TobiasWallner/HighFrequenzyCircuits/Ordering.txt

Resistors-Jumpers
=================

Coils:
======
 * L 
	Or the following one because it allows more current but has slightly less inductance:
	Murata LQW15AN_00 Drosselspule mit Ferrit-Kern, 56 nH / ±5%, 8GHz 200mA, 0402 (1005M) Gehäuse
	https://at.rs-online.com/web/p/smd-induktivitat/8119641

Capazitors:
===========

 * C1, C2 1.5pF (Frequenzy Specific)
	KYOCERA AVX, U, SMD MLCC, Vielschicht Keramikkondensator C0G, 1.5pF ±0.1pF / 200V dc, Gehäuse 0603 (1608M)
	https://at.rs-online.com/web/p/keramik-vielschichtkondensatoren/6983986
	
 * C3 15pF (Frequenzy Specific)
	KYOCERA AVX, U, SMD MLCC, Vielschicht Keramikkondensator C0G, 15pF ±2% / 200V dc, Gehäuse 0805 (2012M)
	https://at.rs-online.com/web/p/keramik-vielschichtkondensatoren/6984042
	
 * C6 0.3pF (Frequenzy Specific)
	ML03V10R3AAT2A
	Keramikvielschichtkondensator, SMD, Hi-Q®, 0.3 pF, 250 V, 0603 [Metrisch: 1608], ± 0.05pF, ML
	https://at.farnell.com/avx/ml03v10r3aat2a/kondensator-0-3pf-250v-0603/dp/2252672
	
 * C4 100p (Can be any other cheap one)
	KYOCERA AVX, U, SMD MLCC, Vielschicht Keramikkondensator C0G, 100pF ±5% / 200V dc, Gehäuse 0805 (2012M)
	https://at.rs-online.com/web/p/keramik-vielschichtkondensatoren/6984036

 * C5 1n (Can be any other cheap one)
	KEMET, C, SMD MLCC, Vielschicht Keramikkondensator X7R, 1nF ±10% / 50V dc, Gehäuse 0603 (1608M)
	https://at.rs-online.com/web/p/keramik-vielschichtkondensatoren/2644551
 
 * 2,2µF (Can be any other cheap one)
	Murata, GCM, SMD MLCC, Vielschicht Keramikkondensator X7R, 2.2μF ±10% / 10V dc, Gehäuse 0805 (2012M), AEC-Q200
	https://at.rs-online.com/web/p/keramik-vielschichtkondensatoren/8202914
	
 * 22nF (Can be any other cheap one)
	Murata, GCM, SMD MLCC, Vielschicht Keramikkondensator X7R, 22nF ±10% / 100V dc, Gehäuse 0603 (1608M), AEC-Q200
	https://at.rs-online.com/web/p/keramik-vielschichtkondensatoren/7235010
 
SMA Connector 50Ohm
https://at.rs-online.com/web/p/koaxial-steckverbinder/8858778
