TobiasWallner/HighFrequenzyCircuits/Documentation/Microstrip Line Calculation For RO400C3 PCB Material at 50Ohm for 2_45GHz.PNG

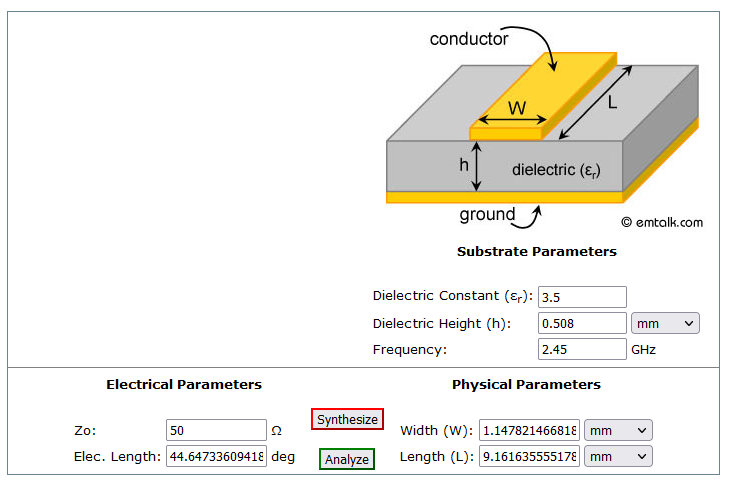
Documentation/Microstrip Line Calculation For RO400C3 PCB Material at 50Ohm for 2_45GHz.PNG
