TobiasWallner/HighFrequenzyCircuits/Documentation/Impedance and Reflectance against permitivity.pdf

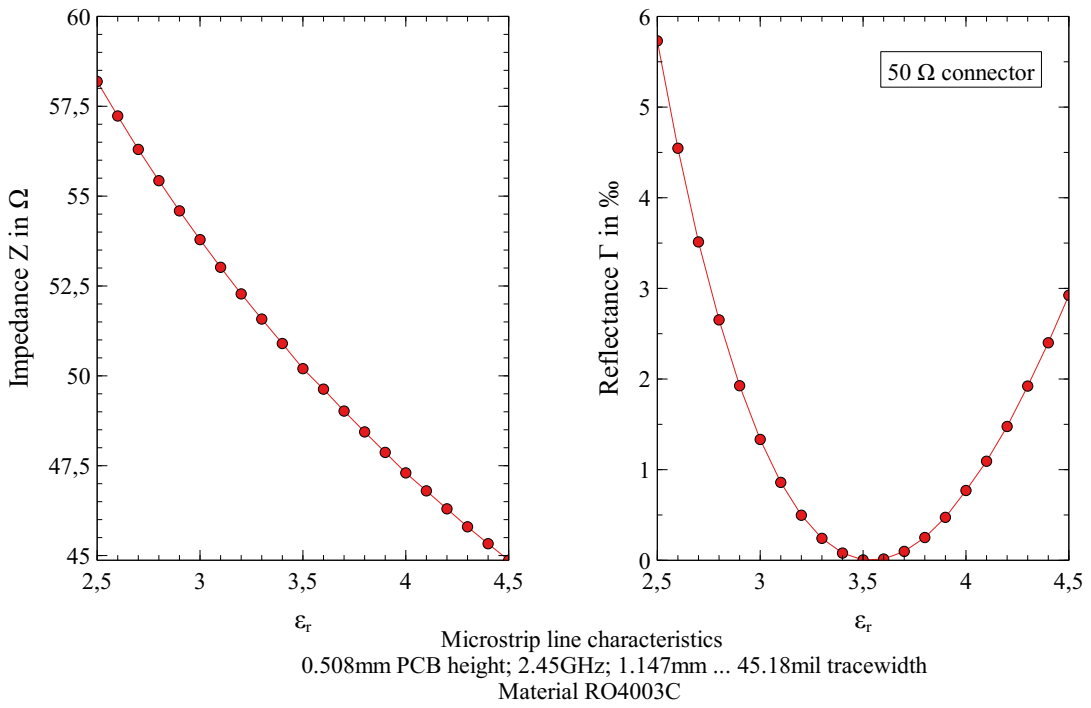
[picture p2: page 1]
Material RO4003C; 50 Ω connector; fle; cta

Microstrip line characteristics

0.508mm PCB height; 2.45GHz; 1.147mm ... 45.18mil tracewidth
