TobiasWallner/HighFrequenzyCircuits/Amplifier2450.brd

## EAGLE design Amplifier2450.brd (2022-04-04)

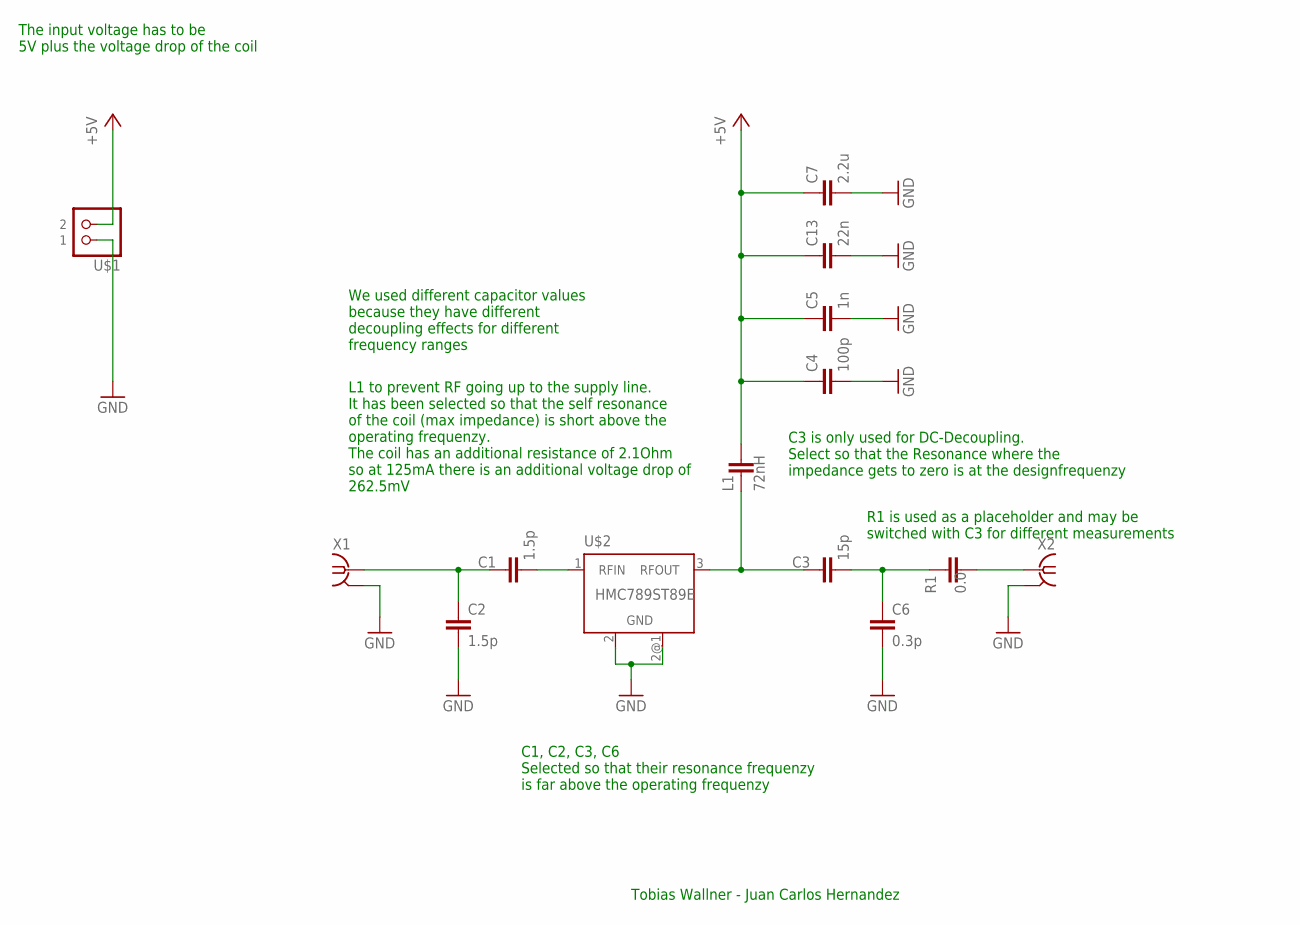
[picture p3: schematic Amplifier2450.sch]

Parts:
C1, C2: 1.5p; C0603
C3: 15p; C0603
C4: 100p; C0603
C5: 1n; C0603
C6: 0.3p; C0603
C7: 2.2u; C0805
C13: 22n; C0603
L1: 72nH; C0603
R1: 0.0; C0603
U$1: SKB_1X02_RM_5.12; RM_5.12_1X02
U$2: HMC789ST89E; SOT89
X1, X2: SMA-142-0701-801/806; J502-ND-142-0701-801/806

Connections:
+5V: C4.1, C5.1, C7.1, C13.1, L1.1, U$1.P$2 (2)
GND: C2.2, C4.2, C5.2, C6.2, C7.2, C13.2, U$1.P$1 (1), U$2.2 (GND), U$2.2@1 (GND), X1.G@1 (2), X1.G@2 (2), X1.G@3 (2), X1.G@4 (2), X2.G@1 (2), X2.G@2 (2), X2.G@3 (2), X2.G@4 (2)
unnamed: C3.1, L1.2, U$2.3 (RFOUT)
unnamed: C1.1, C2.1, X1.1
unnamed: C1.2, U$2.1 (RFIN)
unnamed: C3.2, C6.1, R1.1
unnamed: R1.2, X2.1

Notes on the sheet:
R1 is used as a placeholder and may be switched with C3 for different measurements
We used different capacitor values because they have different decoupling effects for different frequency ranges
Tobias Wallner - Juan Carlos Hernandez
C3 is only used for DC-Decoupling. Select so that the Resonance where the impedance gets to zero is at the designfrequenzy
C1, C2, C3, C6 Selected so that their resonance frequenzy is far above the operating frequenzy
L1 to prevent RF going up to the supply line. It has been selected so that the self resonance of the coil (max impedance) is short above the operating frequenzy. The coil has an additional resistance of 2.1Ohm so at 125mA there is an additional voltage drop of 262.5mV
The input voltage has to be 5V plus the voltage drop of the coil

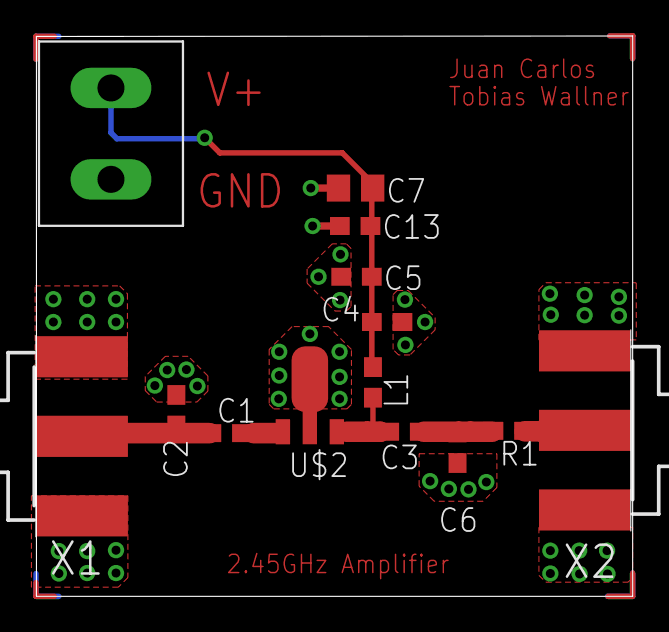
[picture p4: board Amplifier2450.brd from above]

Board: 2 copper layers, 33.1 x 31.1 mm, 14 parts (0 on the bottom side), 7 nets.
