TobiasWallner/HighFrequenzyCircuits/(commit log)

2022-03-24 (JuanCarlos): First Schematic of Amp
    [Amplifier2450.sch]
2022-03-24 (Tobias): selected components and started the layout
    [Amplifier2450.brd, Amplifier2450.sch]
2022-03-28 (Tobias): added datasheets
    [Amplifier2450.brd]
2022-03-28 Finished the PCB design with the following ideas: Cutouts around the signal line to minimize the dielectric losses in the pcb material as well as the coating. cutout to seperate the noisy connector p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
2022-03-28 (Tobias):Added a suitable Zener Diode
2022-03-28 (Tobias): added a top layer ground plane cutout around the signal line to prevent spilling.
    [Amplifier2450.brd, Amplifier2450.sch]
2022-03-28 (Tobias): extended the documentation about the coutout clearence
    [Amplifier2450.brd]
2022-03-28 (Tobias): extended the ordering with a Zener Diode RS-Components link
2022-03-29 (Tobias): started to apply changes from robert 1st meeting
    [Amplifier2450.brd, Amplifier2450.sch]
2022-03-31 (Tobias): halfway applied Roberts feedback
    [Amplifier2450.brd, Amplifier2450.sch]
2022-04-01 (Juanka): Updated PCB
    [Amplifier2450.brd]
2022-04-01 (Tobias): added documentation to the current design, explaining why certain parts and decisions have been made
    [Amplifier2450.brd, Amplifier2450.sch]
2022-04-04 (Tobias): made finishing touches to the design
    [Amplifier2450.brd, Amplifier2450.sch]
2022-04-04 (Tobias): fixed a typo
    [Amplifier2450.brd]
